rrmudry/MBt2/PCB_Design/MBt2_PCB.pdf

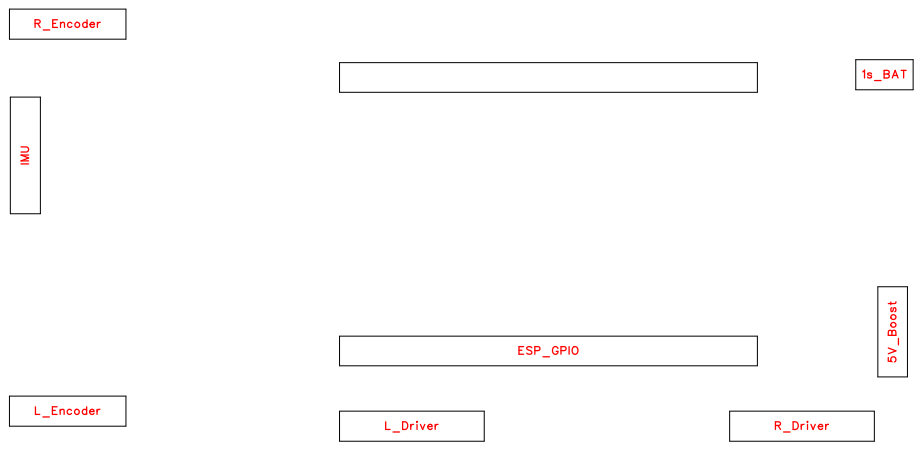
[picture p4: page 1]

No. | Quantity | Comment | Designator | Footprint | Value | Manufacturer Part | Manufacturer | Supplier Part | Supplier
1 | 1 | PZ2.54-1x2P ZZ-L11.5 | 1s_BAT | HDR-TH_PZ 2.54-1X2PZZ -L11.5 | | PZ2.54-1x2P ZZ-L11.5 | SHOU HAN(首韩) | C54876667 | LCSC
2 | 1 | HX PM2.54-1x3P ZC-Y | 5V_Boost | HDR-TH_3P-P2.54-V-F | | HX PM2.54-1x3P ZC-Y | hanxia(韩下) | C22438153 | LCSC
3 | 1 | HX PM2.54-1 x15P ZC | ESP_GPIO | HDR-TH_15 P-P2.54-V-F-1 | | HX PM2.54-1 x15P ZC | hanxia(韩下) | C41417327 | LCSC
4 | 3 | 2.54-1*4P母 | IMU,L_Encoder,R_Encoder | HDR-TH_4P-P2.54-V-F | | 2.54-1*4P母 | BOOMELE( 博穆精密) | C2718488 | LCSC
5 | 2 | 2.54-1*5P母 | L_Driver,R_Driver | HDR-TH_5P-P2.54-V-F | | 2.54-1*5P母 | BOOMELE( 博穆精密) | C50950 | LCSC

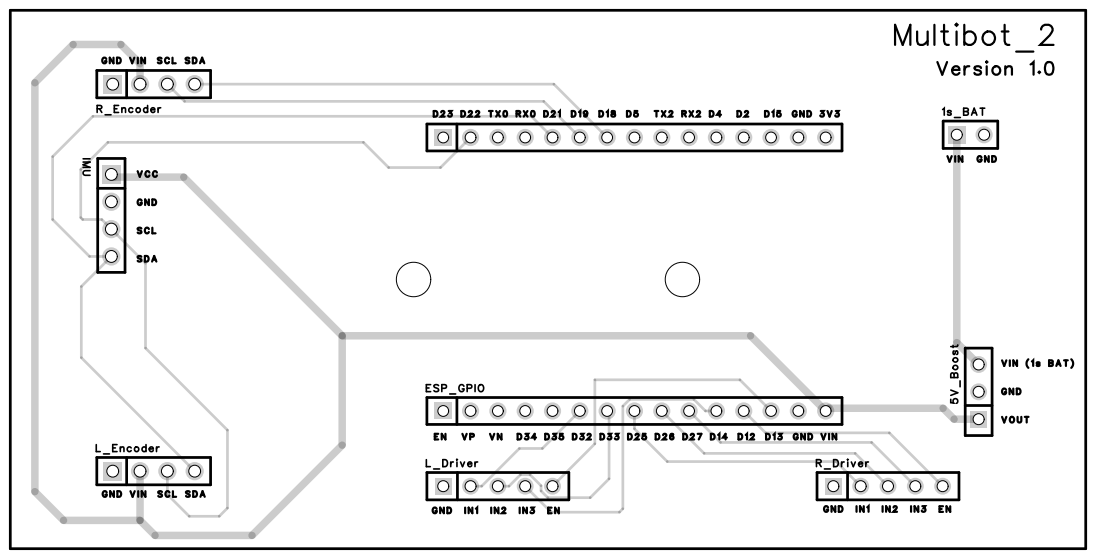
[picture p5: page 4]

GND VIN SCL SDA

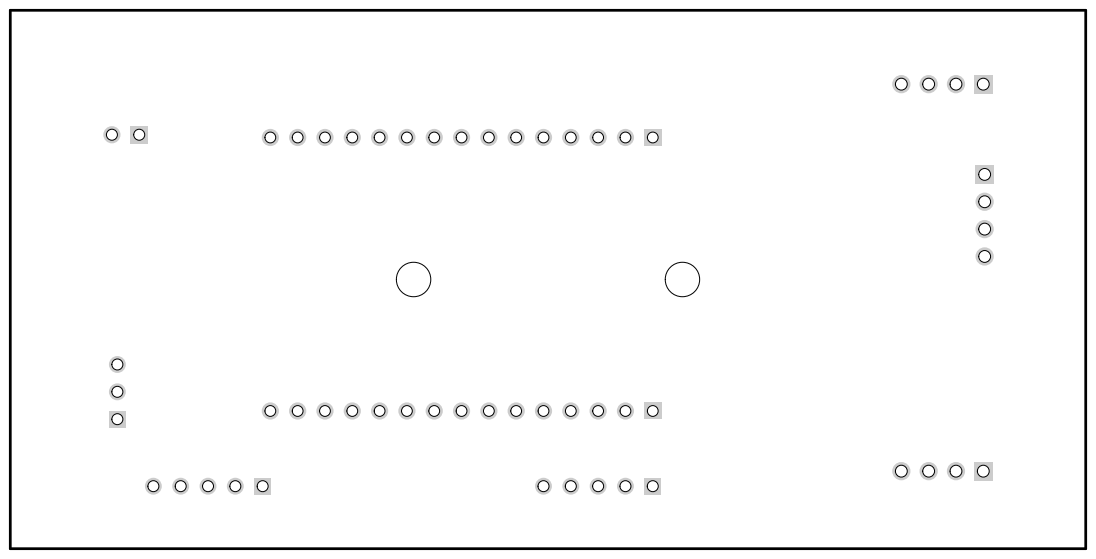
[picture p6: page 5]

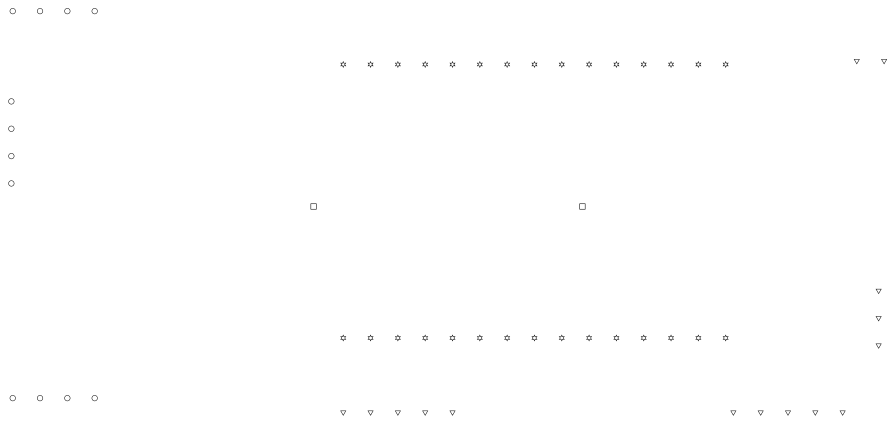
[picture p7: page 6]
