rrmudry/MBt2/(list of files, drawings)

Other design files:
PCB_Design/PCB_simplefocmini_2024-04-26.json
PCB_Design/SCH_simplefocmini_2024-04-26.json
