rrmudry/MBt2/esp32_firmware/src/Config.h

#pragma once

// Left Motor (GM4108H-120T) & SimpleFOC MINI
#define LEFT_MOTOR_EN 13
#define LEFT_MOTOR_PWM_A 32
#define LEFT_MOTOR_PWM_B 33
#define LEFT_MOTOR_PWM_C 14

// Right Motor (GM4108H-120T) & SimpleFOC MINI
#define RIGHT_MOTOR_EN 12
#define RIGHT_MOTOR_PWM_A 25
#define RIGHT_MOTOR_PWM_B 26
#define RIGHT_MOTOR_PWM_C 27

// I2C Bus 0 (Left AS5600 & MPU6050)
#define I2C_0_SDA 21
#define I2C_0_SCL 22

// I2C Bus 1 (Right AS5600)
#define I2C_1_SDA 18
#define I2C_1_SCL 19
