rrmudry/MBt2/(commit log)

2026-07-20 Refactor to dual-core FreeRTOS: isolate FOC+IMU+PID to high-priority task
    - Balance task runs on Core 1 at priority 5 (highest user task)
    - Arduino loop() remains on Core 1 at priority 1 for serial/BT/diagnostics
    - Shared state protected by ESP32 portMUX spinlock
    - Diagnostic streaming moved to loop() so Serial.print never blocks FOC
    - All PID gains, hardware config, and behavior unchanged
2026-07-20 Implement persistent motor calibration to fix USB brownouts
    - Uses Preferences.h to save motor zero angle and direction after initFOC()
    - Subsequent boots skip voltage_sensor_align and load directly from flash
    - Added 'C' serial command to clear calibration and force re-alignment
    [main.cpp]
2026-07-21 Fix untethered I2C crashes, map steering to right stick, increase speed to 20 rad/s, increase safety cutoff to 60 deg
    [main.cpp]
2026-08-03 feat: FreeRTOS dual-core 100Hz Cascaded Dual-Loop PID, Bluepad32 Bluetooth, Auto-Balancing & 9V torque limit
    [PCB_simplefocmini_2024-04-26.json, SCH_simplefocmini_2024-04-26.json]
2026-08-03 hardware: Organize PCB design files into dedicated PCB_Design folder with Gerbers, EasyEDA Pro project, PDF layout, and README
    [PCB_simplefocmini_2024-04-26.json, SCH_simplefocmini_2024-04-26.json]
2026-08-03 docs: Add 3D printable Multiboard Bot Tinkercad CAD link and mechanical design section to README
2026-08-03 docs: Redesign main README.md with badges, system showcase image, mermaid architecture diagram, pinout table, and 3D CAD section
2026-08-03 docs: Update README with high-resolution GUI screenshot and embedded 3D chassis CAD render
2026-08-03 docs: Replace dynamic Mermaid diagram with static high-res PCB Carrier Board layout diagram for instant rendering
2026-08-03 docs: Add complete Bill of Materials (BOM) CSV file and documentation tables
    [BOM_MBt2_Carrier_Board.csv]
2026-08-03 chore: Remove deleted scratch files and test scripts
    [telemetry_capture.csv]
