rrmudry/MBt2/(notices)

Notices in the files:
README.md:
License: CERN-OHL-S / MIT
